afham-b/ufo_shutter/shutter_wires.png

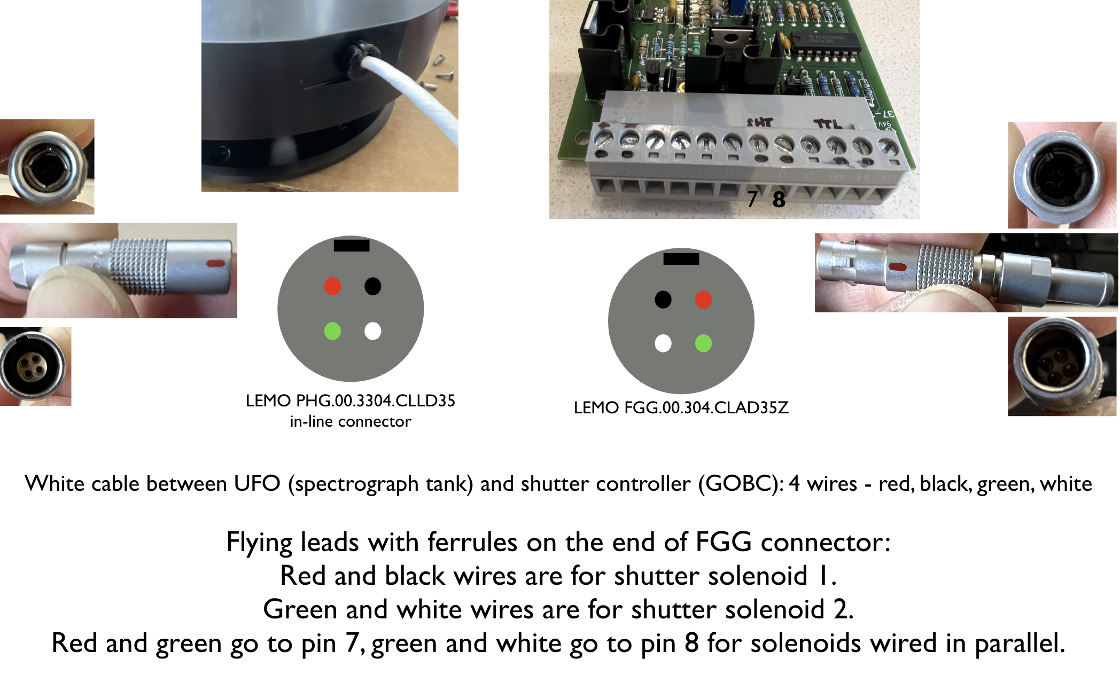
shutter_wires.png
