afham-b/ufo_shutter/command_logs/fast_manual_mixed_20260926_234743_808295.csv

pulse_index | requested_ms | commanded_ms | compensated | send_time_iso | send_time_epoch_s | elapsed_s | success
1 | 4356 | 4356 | 0 | 2026-09-26T23:48:02.793 | 1790480882.793992 | 18.984904 | 1
2 | 4356 | 4356 | 0 | 2026-09-26T23:48:20.776 | 1790480900.776169 | 36.967674 | 1
