afham-b/ufo_shutter/Current_WiringDiagram.png

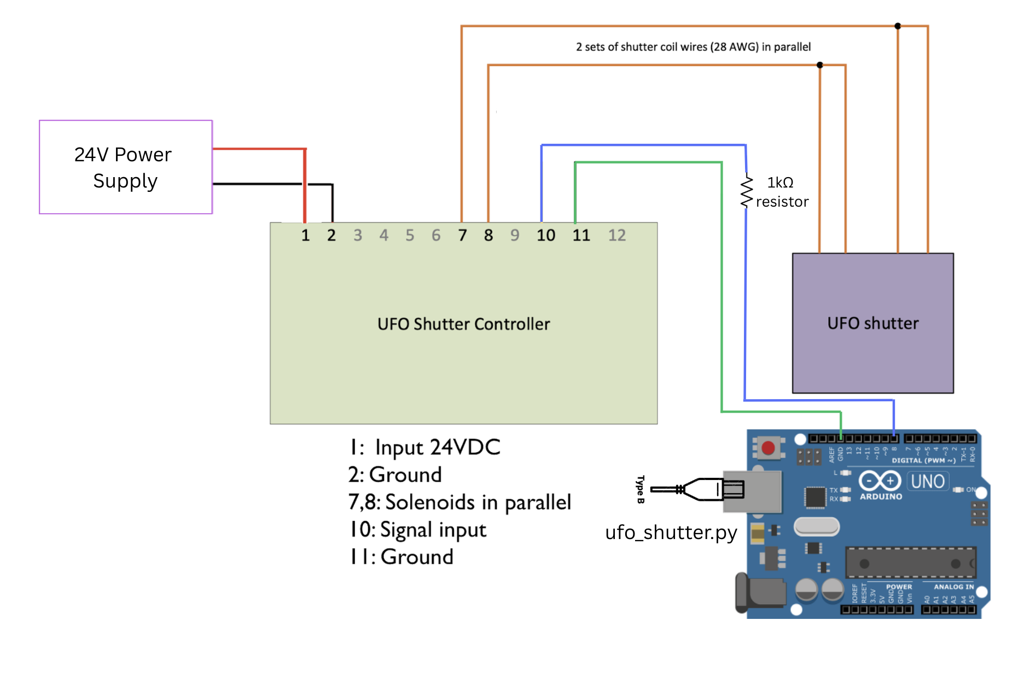
Current_WiringDiagram.png
