afham-b/ufo_shutter/orginal_wiring_diagram.png

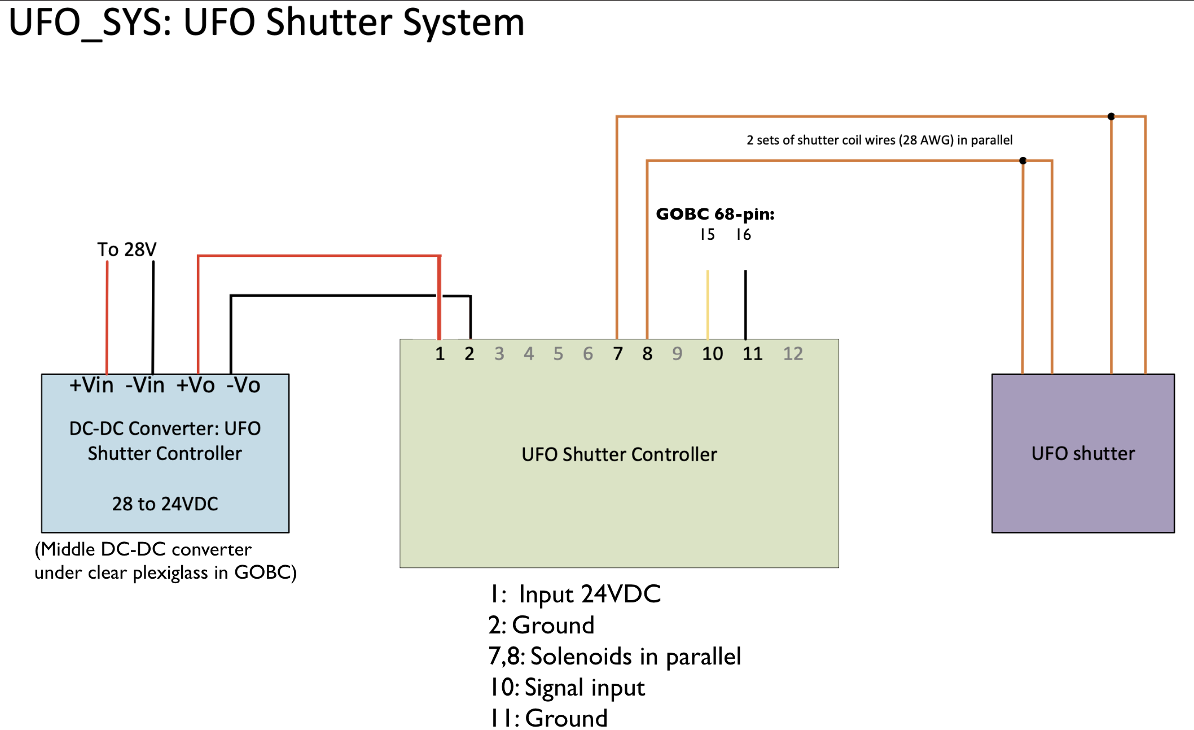
orginal_wiring_diagram.png
