afham-b/ufo_shutter/results_csv_flux/pulse_flux_summary1.csv

pulse_id | start_frame | end_frame | start_time_s | end_time_s | segment_ms_any | baseline | peak_bs | peak_frame | peak_time_s | auc_bs_metric_s | t10_start_frame | t10_end_frame | t10_ms | t50_start_frame | t50_end_frame | t50_ms | t90_start_frame | t90_end_frame | t90_ms
1 | 3574 | 3583 | 7.035419 | 7.053135 | 19.685 | 0.007 | 254.823 | 3578 | 7.043293 | 4.317995 | 3574 | 3583 | 19.685 | 3574 | 3583 | 19.685 | 3576 | 3580 | 9.842
2 | 4604 | 4622 | 9.062974 | 9.098407 | 37.401 | 0.006 | 254.994 | 4608 | 9.070848 | 8.647451 | 4604 | 4622 | 37.401 | 4604 | 4621 | 35.433 | 4606 | 4619 | 27.559
3 | 5639 | 5678 | 11.100371 | 11.177143 | 78.740 | 0.007 | 254.993 | 5643 | 11.108245 | 19.208515 | 5639 | 5678 | 78.740 | 5639 | 5677 | 76.771 | 5641 | 5675 | 68.897
4 | 6685 | 6736 | 13.159422 | 13.259816 | 102.362 | 0.007 | 254.993 | 6688 | 13.165328 | 25.435189 | 6685 | 6736 | 102.362 | 6685 | 6736 | 102.362 | 6686 | 6734 | 96.456
5 | 7742 | 7838 | 15.240127 | 15.429103 | 190.944 | 0.006 | 254.994 | 7745 | 15.246032 | 38.122636 | 7742 | 7838 | 190.944 | 7742 | 7837 | 188.976 | 7744 | 7834 | 179.133
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
