afham-b/ufo_shutter/results_csv_flux/pulse_flux_summary11.csv

pulse_id | start_frame | end_frame | start_time_s | end_time_s | segment_ms_any | baseline | peak_bs | peak_frame | peak_time_s | auc_bs_metric_s | t10_start_frame | t10_end_frame | t10_ms | t50_start_frame | t50_end_frame | t50_ms | t90_start_frame | t90_end_frame | t90_ms
1 | 3130 | 3822 | 6.054046 | 7.392512 | 1340.401 | 0.005 | 254.995 | 3213 | 6.214585 | 35.658230 | 3207 | 3303 | 187.617 | 3209 | 3300 | 177.946 | 3212 | 3297 | 166.341
2 | 4273 | 5256 | 8.264837 | 10.166155 | 1903.253 | 0.005 | 254.995 | 4778 | 9.241608 | 35.759602 | 4772 | 4868 | 187.617 | 4774 | 4865 | 177.946 | 4777 | 4862 | 166.341
3 | 6080 | 6478 | 11.759936 | 12.529748 | 771.746 | 0.005 | 254.995 | 6343 | 12.268631 | 35.761905 | 6337 | 6433 | 187.617 | 6340 | 6430 | 176.012 | 6342 | 6428 | 168.275
4 | 7637 | 8167 | 14.771485 | 15.796611 | 1027.060 | 0.007 | 254.993 | 7910 | 15.299522 | 35.960745 | 7904 | 8000 | 187.617 | 7907 | 7997 | 176.012 | 7909 | 7995 | 168.275
5 | 9429 | 9767 | 18.237572 | 18.891331 | 655.694 | 0.006 | 254.994 | 9476 | 18.328479 | 34.395722 | 9470 | 9562 | 179.881 | 9472 | 9559 | 170.210 | 9475 | 9557 | 160.539
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
