afham-b/ufo_shutter/results_csv_flux/pulse_flux_summary12.csv

pulse_id | start_frame | end_frame | start_time_s | end_time_s | segment_ms_any | baseline | peak_bs | peak_frame | peak_time_s | auc_bs_metric_s | t10_start_frame | t10_end_frame | t10_ms | t50_start_frame | t50_end_frame | t50_ms | t90_start_frame | t90_end_frame | t90_ms
1 | 2942 | 3499 | 5.668351 | 6.741523 | 1075.099 | 0.005 | 254.995 | 3153 | 6.074885 | 36.409793 | 3147 | 3243 | 186.890 | 3149 | 3241 | 179.183 | 3151 | 3238 | 169.550
2 | 4676 | 4956 | 9.009249 | 9.548725 | 541.403 | 0.006 | 254.994 | 4721 | 9.095951 | 36.053738 | 4715 | 4811 | 186.890 | 4717 | 4809 | 179.183 | 4720 | 4806 | 167.623
3 | 6181 | 6420 | 11.908933 | 12.369414 | 462.408 | 0.006 | 254.994 | 6289 | 12.117016 | 36.608778 | 6282 | 6379 | 188.817 | 6285 | 6377 | 179.183 | 6287 | 6374 | 169.550
4 | 7830 | 8522 | 15.086061 | 16.419337 | 1335.203 | 0.005 | 254.995 | 7854 | 15.132302 | 35.189326 | 7848 | 7943 | 184.963 | 7851 | 7940 | 173.403 | 7853 | 7937 | 163.770
5 | 9314 | 9652 | 17.945284 | 18.596508 | 653.151 | 0.006 | 254.994 | 9424 | 18.157221 | 34.938103 | 9418 | 9512 | 183.037 | 9421 | 9509 | 171.476 | 9423 | 9506 | 161.843
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
