afham-b/ufo_shutter/results_csv_flux/pulse_flux_summary2.csv

pulse_id | start_frame | end_frame | start_time_s | end_time_s | segment_ms_any | baseline | peak_bs | peak_frame | peak_time_s | auc_bs_metric_s | t10_start_frame | t10_end_frame | t10_ms | t50_start_frame | t50_end_frame | t50_ms | t90_start_frame | t90_end_frame | t90_ms
1 | 4544 | 4566 | 8.840352 | 8.883153 | 44.746 | 0.007 | 254.993 | 4548 | 8.848134 | 10.697590 | 4544 | 4566 | 44.746 | 4544 | 4566 | 44.746 | 4546 | 4564 | 36.965
2 | 5583 | 5621 | 10.861726 | 10.935655 | 75.874 | 0.007 | 254.993 | 5586 | 10.867563 | 18.551923 | 5583 | 5621 | 75.874 | 5583 | 5620 | 73.929 | 5585 | 5618 | 66.147
3 | 6629 | 6721 | 12.896719 | 13.075705 | 180.931 | 0.007 | 254.993 | 6633 | 12.904501 | 35.784066 | 6629 | 6721 | 180.931 | 6629 | 6720 | 178.986 | 6631 | 6717 | 169.258
4 | 7687 | 7785 | 14.955058 | 15.145717 | 192.605 | 0.007 | 254.993 | 7691 | 14.962840 | 38.640690 | 7687 | 7785 | 192.605 | 7687 | 7784 | 190.659 | 7689 | 7781 | 180.931
5 | 8757 | 8880 | 17.036744 | 17.276040 | 241.242 | 0.007 | 254.993 | 8760 | 17.042580 | 51.184134 | 8757 | 8880 | 241.242 | 8757 | 8879 | 239.296 | 8759 | 8876 | 229.569
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
