afham-b/ufo_shutter/results_csv_flux/pulse_flux_summary3.csv

pulse_id | start_frame | end_frame | start_time_s | end_time_s | segment_ms_any | baseline | peak_bs | peak_frame | peak_time_s | auc_bs_metric_s | t10_start_frame | t10_end_frame | t10_ms | t50_start_frame | t50_end_frame | t50_ms | t90_start_frame | t90_end_frame | t90_ms
1 | 3726 | 3734 | 7.334631 | 7.350379 | 17.716 | 0.006 | 236.290 | 3729 | 7.340536 | 3.522944 | 3726 | 3734 | 17.716 | 3726 | 3734 | 17.716 | 3728 | 3731 | 7.874
2 | 4757 | 4775 | 9.364154 | 9.399587 | 37.401 | 0.006 | 254.994 | 4761 | 9.372028 | 8.624670 | 4757 | 4775 | 37.401 | 4757 | 4774 | 35.433 | 4759 | 4772 | 27.559
3 | 5791 | 5829 | 11.399583 | 11.474386 | 76.771 | 0.008 | 254.992 | 5795 | 11.407457 | 18.844706 | 5791 | 5829 | 76.771 | 5791 | 5829 | 76.771 | 5793 | 5827 | 68.897
4 | 6837 | 6928 | 13.458634 | 13.637768 | 181.102 | 0.007 | 254.993 | 6840 | 13.464540 | 36.013503 | 6837 | 6928 | 181.102 | 6837 | 6928 | 181.102 | 6839 | 6925 | 171.260
5 | 7821 | 7919 | 15.395638 | 15.588551 | 194.881 | 0.007 | 254.993 | 7824 | 15.401544 | 39.214609 | 7821 | 7919 | 194.881 | 7821 | 7919 | 194.881 | 7823 | 7916 | 185.039
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
