afham-b/ufo_shutter/(commit log)

2025-12-05 shutter.py working and wiring diagram added, with images of original wiring
2026-01-10 added dual shutters, with dpdt switch relay, will add documentation and wiring diagram when back EMF issues resolved
    [ufo_shutter.py]
2026-01-14 multi shutter system works! wiring diagram and documentation will be added next
2026-01-22 added shutter calibration tests
    [shutter_timing_results_112fps.csv, shutter_timing_results_451fps.csv]
2026-01-23 new offset model found, needs retest with new model and wide camera
    [shutter_timing_results_SWO_edgeROI.csv, shutter_timing_results_SW_edgeROI_99thresold.csv, shutter_timing_results_defuse_SWO_457fps.csv, shutter_timing_results_defuse_SW_457fps.csv, shutter_timing_results_defuse_SW_457fps_2.csv]
2026-02-05 flux analysis and results, need to rerun with led lightsource
    [pulse_flux_summary1.csv, pulse_flux_summary10.csv, pulse_flux_summary11.csv, pulse_flux_summary12.csv, pulse_flux_summary2.csv, pulse_flux_summary3.csv, pulse_flux_summary4.csv, pulse_flux_summary5.csv]
2026-07-22 new documentation and unpdated shutter script
    [pulse_flux_summary.csv, pulse_flux_summary1.csv, pulse_flux_summary10.csv, pulse_flux_summary11.csv, pulse_flux_summary12.csv, pulse_flux_summary2.csv, pulse_flux_summary3.csv, pulse_flux_summary4.csv]
2026-09-27 added auto port finder, single shutter fast mode, updated documentation
    [fast_manual_mixed_20260926_234743_808295.csv, sw_durations4_raw_20260919_210629.csv]
